oeps-tech/OE-PyBoard-tester/PCB/OE PyBoard tester FootprintLib/SW_SPST_TL3305B.step

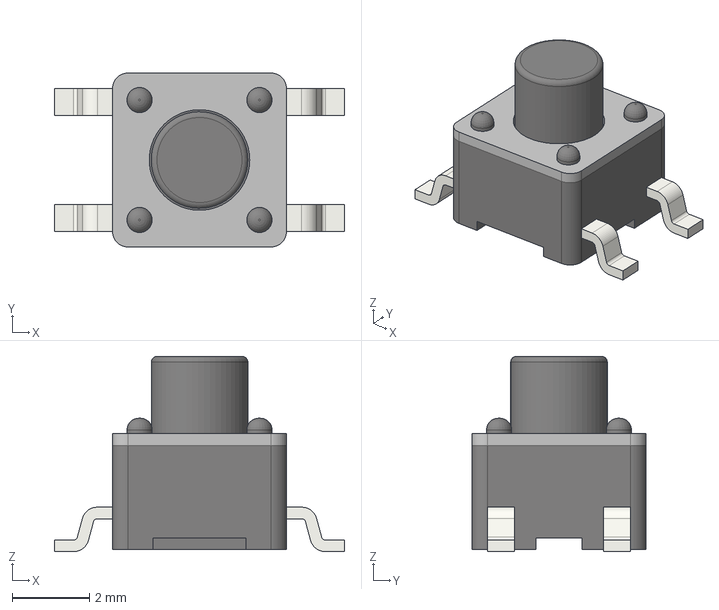
[picture p1: CAD file, 2026-01-21]
PCB/OE PyBoard tester FootprintLib/SW_SPST_TL3305B.step
7.50 x 4.50 x 5.05 mm
