oeps-tech/OE-PyBoard-tester/PCB/OE PyBoard tester FootprintLib/TSW-116-06-T-S.stp

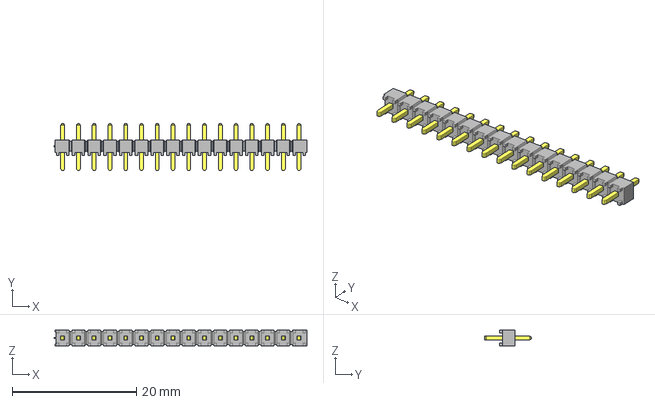
[picture p2: CAD file, 2026-01-21]
PCB/OE PyBoard tester FootprintLib/TSW-116-06-T-S.stp
40.8 x 7.62 x 2.54 mm
TSW-116-06-T-S_body
T-1S6-18-TSW-1-06-16-S
