oeps-tech/OE-PyBoard-tester/PCB/OE PyBoard tester FootprintLib/475710001.stp

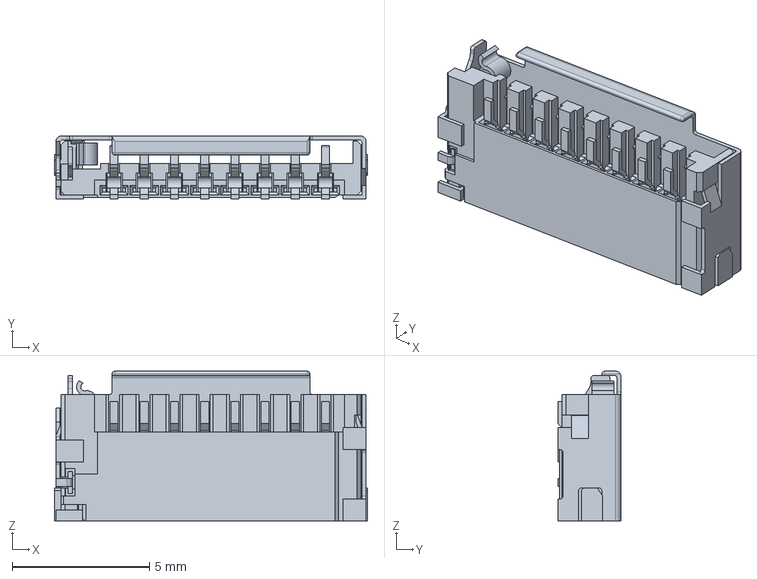
[picture p4: CAD file, 2026-01-21]
PCB/OE PyBoard tester FootprintLib/475710001.stp
11.4 x 2.30 x 5.45 mm
