oeps-tech/OE-PyBoard-tester/Firmware/PyBoardTester/registers.xls

Sheet: registers
Has event. | When | Type | Array | Array Len. | Register Name | Desciption | Mask Type | Value | Name | Desciption
no |  | U16 | no |  | SWITCHES | Controls the switches like they were pressed in the physical board | bit | (1<<0) | SW_START
 |  |  |  |  |  |  | bit | (1<<1) | SW_LED_SEQUENCE_OK
 |  |  |  |  |  |  | bit | (1<<2) | SW_LED_SEQUENCE_NOK
yes | Every 100 ms | FLOAT | yes | 8 | READINGS | V_3V3_1, V_3V3_2, V_Plus_1, V_Plus_2, SW_Start, SW_LedSequence, CurrentState, PassFail
no |  | U16 | no |  | CONTROL | Controls internal signals | bit | (1<<0) | LED_START
no |  | U16 | no |  | CONTROL_SET | Controls internal signals | bit | (1<<1) | LED_RST2
no |  | U16 | no |  | CONTROL_CLEAR | Controls internal signals | bit | (1<<2) | LED_SUPPLY
 |  |  |  |  |  |  | bit | (1<<3) | LED_IOS
 |  |  |  |  |  |  | bit | (1<<4) | LED_PASS
 |  |  |  |  |  |  | bit | (1<<5) | LED_FAIL
 |  |  |  |  |  |  | bit | (1<<6) | LED_V_PLUS_1
 |  |  |  |  |  |  | bit | (1<<7) | LED_V_PLUS_2
 |  |  |  |  |  |  | bit | (1<<8) | LED_V_V3V_1
 |  |  |  |  |  |  | bit | (1<<9) | LED_V_V3V_2
 |  |  |  |  |  |  | bit | (1<<10) | SOUND_WAIT_FOR_BUTTON
 |  |  |  |  |  |  | bit | (1<<11) | SOUND_PASS
 |  |  |  |  |  |  | bit | (1<<12) | SOUND_FAIL

Sheet: meta data
who am I: | 0
firmware major version: | 0
firmware minor version: | 1
hardware major version: | 1
hardware minor version: | 0
assembly version: | 0
device name: | PyBoardTester

Sheet: ios
Pin Name | PORT | Pin | Direction | Use Input | Out | Out default | Pull | Sense | Int. priority | Int. number | Desciption | Neg. Output
RST2 | PORTA | 5 | input |  |  |  | tristate | both_edges | off
SW_START | PORTD | 4 | input |  |  |  | up | both_edges | off
SW_LED_SEQUENCE_OK | PORTC | 2 | input |  |  |  | up | both_edges | off
SW_LED_SEQUENCE_NOK | PORTC | 3 | input |  |  |  | up | both_edges | off
LED_START | PORTD | 0 | output | yes | digital | 0 |  |  |  |  |  | no
LED_RST2 | PORTD | 1 | output | yes | digital | 0 |  |  |  |  |  | no
LED_SUPPLY | PORTD | 2 | output | yes | digital | 0 |  |  |  |  |  | no
LED_IOS | PORTD | 3 | output | yes | digital | 0 |  |  |  |  |  | no
LED_PASS | PORTC | 0 | output | yes | digital | 0 |  |  |  |  |  | no
LED_FAIL | PORTC | 1 | output | yes | digital | 0 |  |  |  |  |  | no
LED_V_PLUS_1 | PORTC | 4 | output | yes | digital | 0 |  |  |  |  |  | no
LED_V_PLUS_2 | PORTC | 6 | output | yes | digital | 0 |  |  |  |  |  | no
LED_V_V3V_1 | PORTC | 5 | output | yes | digital | 0 |  |  |  |  |  | no
LED_V_V3V_2 | PORTC | 7 | output | yes | digital | 0 |  |  |  |  |  | no
RESULT_0 | PORTB | 0 | input |  |  |  | tristate | both_edges | off
RESULT_1 | PORTB | 1 | input |  |  |  | tristate | both_edges | off
RESULT_2 | PORTB | 2 | input |  |  |  | tristate | both_edges | off

Sheet: options
Array | Type | Array | Bits type | Type | Mask Type | Direction | Use input | Pull | Sense | Int. priority | Int. number | Int. Mask | Out | Neg. Output
 |  |  |  | U8 | group_mask | input | yes | up | both_edges | low | 0 |  | digital | yes
yes | U8 | yes | bit | U16 | mask | output | no | down | rising_edge | med | 1 |  | wire_or | no
no | U16 | no | mask | U32 | bit |  |  | tristate | falling_edge | high |  |  | wire_and
 | U32 |  | group_mask | U64 |  |  |  | busholder | low_level | off |  |  | wired_or_pull
 | U64 |  |  | I8 |  |  |  |  | no_interrupt |  |  |  | wired_and_pull
 | I8 |  |  | I16
 | I16 |  |  | I32
 | I32 |  |  | I64
 | I64 |  |  | FLOAT
 | FLOAT
