oeps-tech/OE-PyBoard-tester/(commit log)

2025-12-09 Added .gitignore for KiCad project files
2026-01-21 Add OE PyBoard tester PCB design files
    Initial commit of the OE PyBoard tester project.
    [475710001.stp, ECS-.327-12.5-17X-C-TR.step, OE PyBoard tester BOM.csv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]
2026-06-10 Add firmware .gitignore and registers.xls
    [registers.xls]
2026-06-10 Move registers.xls to PyBoardTester
    Rename registers.xls from Firmware/AcquisitionTester to Firmware/PyBoardTester (100% identical file). No content changes—just relocating the spreadsheet to reflect directory reorganization.
    [registers.xls]
2026-08-21 Add PyBoard DUT shunt-test firmware
    Add MicroPython firmware (Firmware - DUT/main.py) implementing a DUT shunt test. The script configures test pins with required pull-ups or no-pull, drives each pin low to verify exactly two pins read logic-zero, shows a 4-bit debug code on the on-board LEDs on failure, and reports pass/fail via Y6/Y7/Y8. Includes debug timing constants and a final LED blink loop after the test.
    [main.py]
2026-08-21 Add PyBoardTester firmware and assets
    [registers.xls]
